GodOfjiz/Temperature_Humidity-ESP32-Board/temp-humidity sensor.kicad_pcb

## KiCad design temp-humidity sensor.kicad_pcb (2026-07-04)

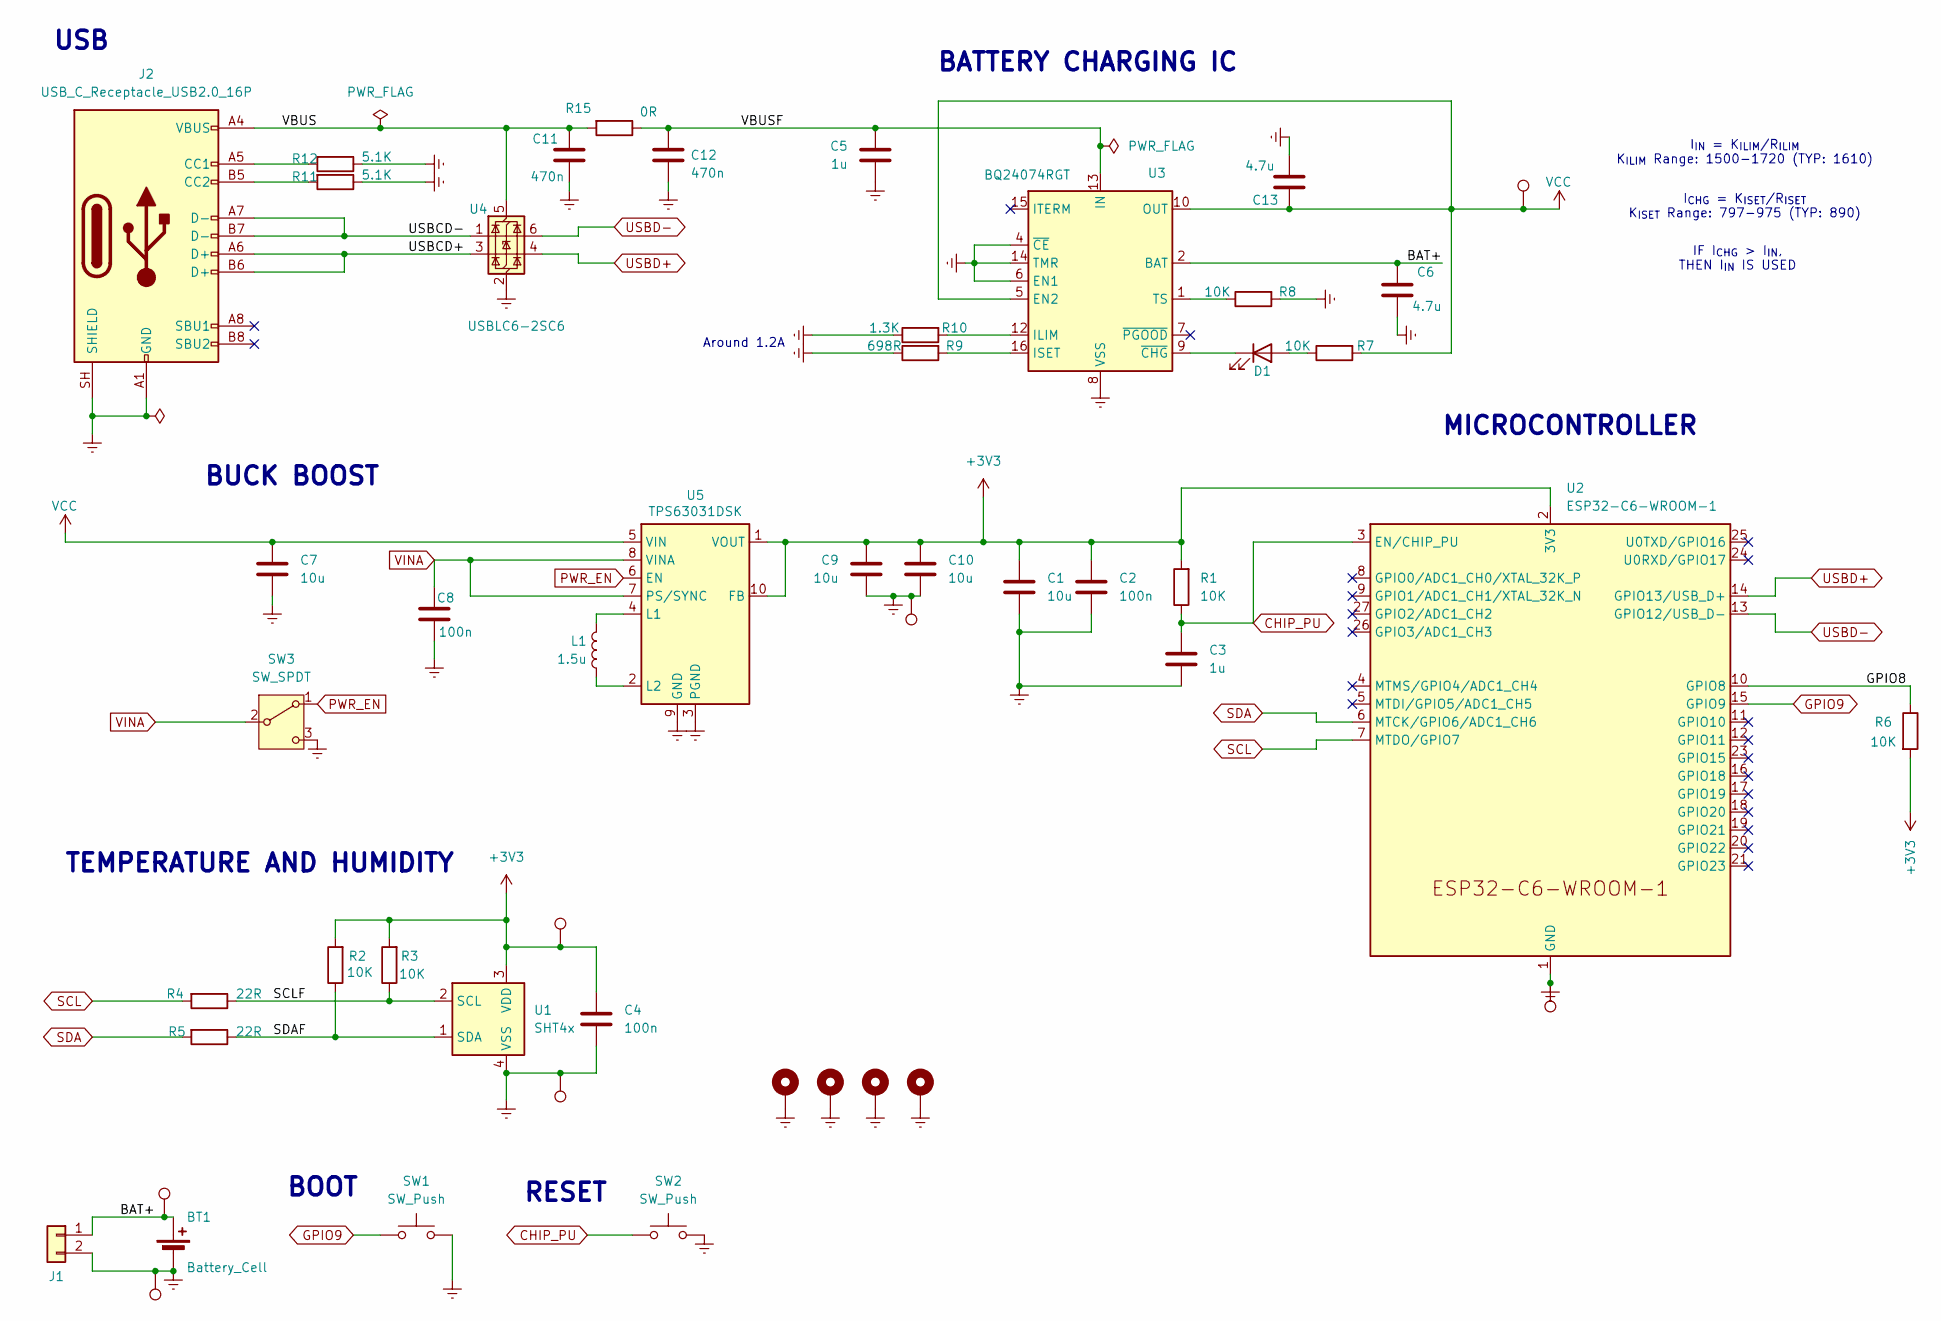
[picture p1: schematic temp-humidity sensor.kicad_sch, THM]

Parts:
BT1: Battery_Cell
C1, C7, C9, C10: 10u; C_0805_2012Metric; LCSC C5448891
C2: 100n; C_0805_2012Metric; LCSC C111492
C3: 1u; C_0603_1608Metric; LCSC C106248
C4, C8: 100n; C_0603_1608Metric; LCSC C77055
C5: 1u; C_0805_2012Metric; LCSC C91185
C6, C13: 4.7u; C_0805_2012Metric; LCSC C354262
C11, C12: 470n; C_0603_1608Metric; LCSC C513577
D1: LED; LED_0805_2012Metric; LCSC C19171391
H1, H2, H3, H4: MountingHole; MountingHole_3.2mm_M3_ISO7380_Pad_TopBottom
J1: Conn_01x02; JST_PH_B2B-PH-K_1x02_P2.00mm_Vertical; LCSC Part C131337
J2: USB_C_Receptacle_USB2.0_16P; USB_C_Receptacle_G-Switch_GT-USB-7010ASV; LCSC C2765186
L1: 1.5u; L_Changjiang_FXL0630; LCSC C167217
R1, R2, R3, R6, R7, R8: 10K; R_0603_1608Metric; LCSC C2930027
R4, R5: 22R; R_0603_1608Metric; LCSC C2907129
R9: 698R; R_0603_1608Metric; LCSC C7467401
R10: 1.3K; R_0603_1608Metric; LCSC C2906977
R11, R12: 5.1K; R_0603_1608Metric; LCSC C2907044
R15: 0R; R_0603_1608Metric; LCSC C95177
SW1, SW2: SW_Push; SW_Push_SPST_NO_Alps_SKRK; LCSC C36938886
SW3: SW_SPDT; SW_Slide_SPDT_Straight_CK_OS102011MS2Q
TP2, TP3, TP5, TP6, TP7, TP8, TP9: TestPoint; TestPoint_Pad_D1.0mm
U1: SHT4x; Sensirion_DFN-4_1.5x1.5mm_P0.8mm_SHT4x_NoCentralPad; LCSC C54946589
U2: ESP32-C6-WROOM-1; LCSC C5366877
U3: BQ24074RGT; VQFN-16-1EP_3x3mm_P0.5mm_EP1.6x1.6mm; LCSC C54313
U4: USBLC6-2SC6; SOT-23-6; LCSC C2687116
U5: TPS63031DSK; WSON-10-1EP_2.5x2.5mm_P0.5mm_EP1.2x2mm; LCSC C15516

Connections:
+3V3: C1.1, C2.1, C4.1, C9.1, C10.1, R1.2, R2.2, R3.2, R6.2, TP2.1 (1_1), U1.3 (VDD), U2.2 (3V3), U5.1 (VOUT), U5.10 (FB)
/BAT+: BT1.1 (+), C6.1, J1.1, TP5.1 (1_1), U3.2 (BAT), U3.3 (BAT)
/GPIO8: R6.1, U2.10 (GPIO8)
/SCLF: R3.1, R4.1, U1.2 (SCL)
/SDAF: R2.1, R5.1, U1.1 (SDA)
/USBCD+: J2.A6 (D+), J2.B6 (D+), U4.3 (I/O2)
/USBCD-: J2.A7 (D-), J2.B7 (D-), U4.1 (I/O1)
/VBUS: C11.1, J2.A4 (VBUS), J2.A9 (VBUS), J2.B4 (VBUS), J2.B9 (VBUS), R15.2, U4.5 (VBUS)
/VBUSF: C5.1, C12.1, R15.1, U3.13 (IN)
CHIP_PU: C3.1, R1.1, SW2.1, U2.3 (EN/CHIP_PU)
Earth: BT1.2 (-), C1.2, C2.2, C3.2, C4.2, C5.2, C6.2, C7.2, C8.2, C9.2, C10.2, C11.2, C12.2, C13.2, H1.1 (1_1), H2.1 (1_1), H3.1 (1_1), H4.1 (1_1), J1.2, J2.A1 (GND), J2.A12 (GND), J2.B1 (GND), J2.B12 (GND), J2.SH (SHIELD), R8.2, R9.1, R10.1, R11.1, R12.1, SW1.2, SW2.2, SW3.3 (C), TP6.1 (1_1), TP7.1 (1_1), TP8.1 (1_1), TP9.1 (1_1), U1.4 (VSS), U2.1 (GND), U2.28 (GND), U2.29 (GND), U3.4 (~CE), U3.6 (EN1), U3.8 (VSS), U3.14 (TMR), U3.17 (VSS), U4.2 (GND), U5.3 (PGND), U5.9 (GND), U5.11 (PGND)
GPIO9: SW1.1, U2.15 (GPIO9)
unnamed: D1.2 (A), R7.1
unnamed: D1.1 (K), U3.9 (~CHG)
unnamed: J2.A5 (CC1), R12.2
unnamed: J2.B5 (CC2), R11.2
unnamed: R10.2, U3.12 (ILIM)
unnamed: R9.2, U3.16 (ISET)
unnamed: R8.1, U3.1 (TS)
unnamed: L1.1, U5.4 (L1)
unnamed: L1.2, U5.2 (L2)
PWR_EN: SW3.1 (A), U5.6 (EN)
SCL: R4.2, U2.7 (MTDO/GPIO7)
SDA: R5.2, U2.6 (MTCK/GPIO6/ADC1_CH6)
USBD+: U2.14 (GPIO13/USB_D+), U4.4 (I/O2)
USBD-: U2.13 (GPIO12/USB_D-), U4.6 (I/O1)
VCC: C7.1, C13.1, R7.2, TP3.1 (1_1), U3.5 (EN2), U3.10 (OUT), U3.11 (OUT), U5.5 (VIN)
VINA: C8.1, SW3.2 (B), U5.7 (PS/SYNC), U5.8 (VINA)

Notes on the sheet:
BOOT
BUCK BOOST
RESET
BATTERY CHARGING IC
USB
Around 1.2A
IF I_{CHG} > I_{IN}, THEN I_{IN} IS USED
I_{IN} = K_{ILIM}/R_{ILIM} K_{ILIM} Range: 1500-1720 (TYP: 1610)
I_{CHG} = K_{ISET}/R_{ISET} K_{ISET} Range: 797-975 (TYP: 890)
TEMPERATURE AND HUMIDITY
MICROCONTROLLER

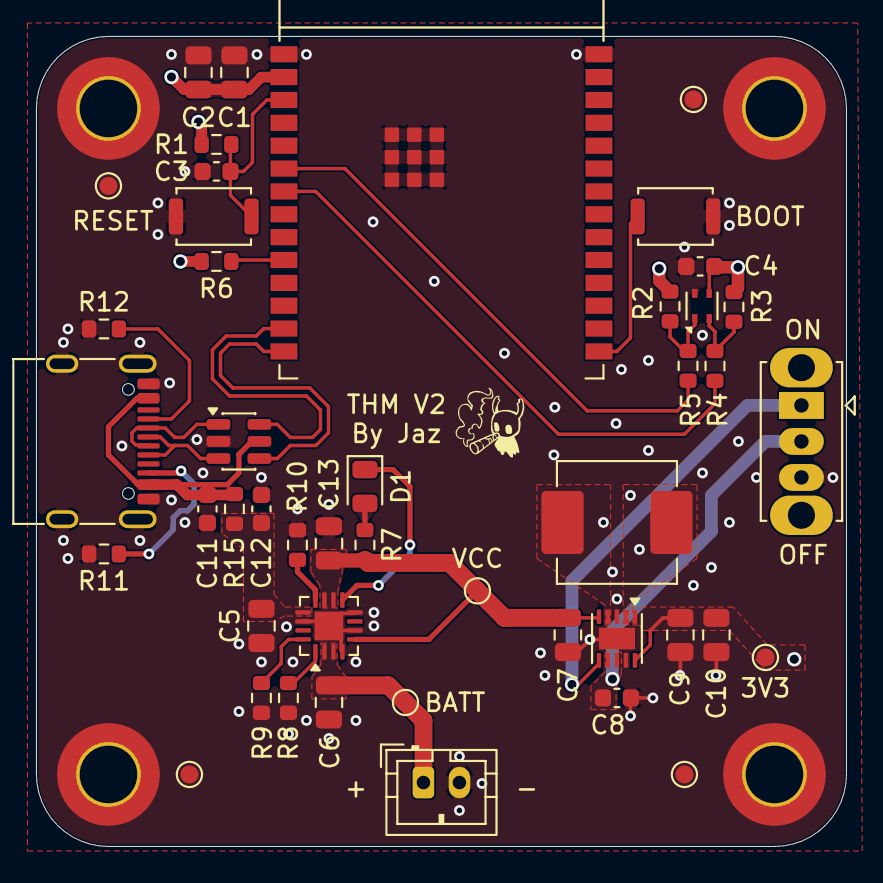
[picture p2: board temp-humidity sensor.kicad_pcb from above]

Board: 4 copper layers, 45.0 x 45.0 mm, 49 parts (0 on the bottom side), 28 nets.
