GodOfjiz/Temperature_Humidity-ESP32-Board/(commit log)

2026-05-28 Finished Schematic
    [temp-humidity sensor.kicad_pcb, temp-humidity sensor.kicad_sch]
2026-06-01 Working On PCB
    [temp-humidity sensor.kicad_pcb, temp-humidity sensor.kicad_sch]
2026-06-02 Finished Design
    [temp-humidity sensor.kicad_pcb, temp-humidity sensor.kicad_sch]
2026-06-08 Update to V3
    [temp-humidity sensor.kicad_pcb, temp-humidity sensor.kicad_sch]
2026-06-10 Udpated to V3.1
    [temp-humidity sensor.kicad_pcb, temp-humidity sensor.kicad_sch]
2026-07-04 Improved design
    [temp-humidity sensor.kicad_pcb, temp-humidity sensor.kicad_sch]
